jackdev23/morsedecode/EnhancedMorseDecoder/Code/SDRLxx_EnhancedMorseDecoder_DesignDescription.docx

# 33f

# Project Blue Horizon - Increment V

# Enhanced Morse Decoder

# Hardware Design Description

Revision | -
Date: | [ISSUE DATE]

Document Number: | [SDRLxx]
Status: | [DRAFT]
SDRL No: | xX
DOORS™ Module Reference: | N/A
Classification: | Unclassified

Dylan Thorner

Sean Winfree

This document is the property of ASCEND. If found, please return it to:

Lockheed Martin System Integration, ELDP Offices, 1801 State Route 17C
Owego, NY 13827-3998

Together with your name and address. Letter postage need not be prepaid.

Lockheed Martin Owego's Engineering Leadership Development Program (ELDP) is dedicated to the professional development of the company's future technical and business leaders. This comprehensive three-year program consists of rotational work assignments (http://www.owg.fs.lmco.com/projects/ldp/eldp/assignments.html), (http://www.owg.fs.lmco.com/projects/ldp/eldp/assignments.html) leadership training, and technical graduate studies leading to a Master of Engineering degree in Systems Engineering from Cornell University (http://www.owg.fs.lmco.com/projects/ldp/eldp/cornell.html). This proven combination of academics, in-house training and rotational assignments provides entry-level professionals with the broad-based exposure that will facilitate their ability to perform with distinction in the challenging leadership roles within Lockheed Martin Systems Integration.

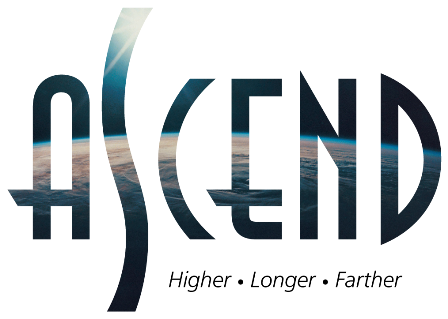
[picture p11: figure]

# Issue Record

The content of this document is wholly defined by the issue number and, where appropriate, the revision letter detailed below. The document will be reproduced in its entirety when any change has been incorporated and approved.

This document is under Configuration Control and any changes to the document will be subject to a change request via Configuration Management.

Revision | Incorporated by | Revision Date | Description of Change | CR(s) Applied
- | Sean Winfree | 12/31/2010 | DRAFT

# Authorization Notification

# Prepared by: Sean Winfree, Chief Engineer

# ASCEND;

Dylan Thorner, Engineer

Enhanced Solutions

# Approved by: <<APPROVER>>, <<ROLE>>

# ASCEND

# Contents

Figures

Tables

References

This table lists the documents applicable to the Hardware Design Docuement. It includes documents referred to in the text as well as related complementary documents that could be of interest to the reader.

ASCEND Docuementation

All ASCEND Documentation listed below is available in the Configuration Management (https://sharepoint.global.lmco.com/sites/Project-Blue-Horizon/PBH%202011/Forms/AllItems.aspx) folder on the PBH Sharepoint.

Doc # | Document Title
XX-XXX | Enhanced Morse Decoder White Paper
XX-XXX | Enhanced Morse Decoder ICD

Enhanced Solutions Docuementation

The following table lists all supporting documentation provided by Enhanced Solutions in reference to the design.

Doc # | Document Title
xx-xxx | Enhanced Morse Decoder Schematics
xx-xxx | Enhanced Morse Decoder Bill Of Materials
xx-xxx | Enhanced Morse Decoder Layout Artwork Images

Supplier Docuementation

The following table lists key supporting documentation provided by suppliers of components used in the design.

Doc # | Document Title
DS70xxxx | dsPIC33F Family Reference Manual Part 1 (24-Apr-2009)
DS51700A | MPLAB Starter Kit fordsPIC® Digital Signal Controllers User’s Guide

# 1. Scope

This Hardware Design Document (HDD) serves as both a receptacle of parts of the design and a pointer to additional descriptions of the design of the Hardware Configuration Items (HWCI) identified as the Enhanced Morse Decoder of the Project Blue Horizion (PBH) systems. This design was derived from requirements contained within the PBHV System Specification. All information required to understand the design of these HWCI is either provided here or assessed and referenced from this document.

The artifacts in the document were generated as part of the preliminary and detailed design phase as documented in the ASCEND PBH Intergrated Master Schedule.

## 1.1 System Overview

The PBH Increment V systems include the Air Vehicle and Ground Segment. Figure 1: PBH Inc. V System Overview details the interaction between the individual systems.

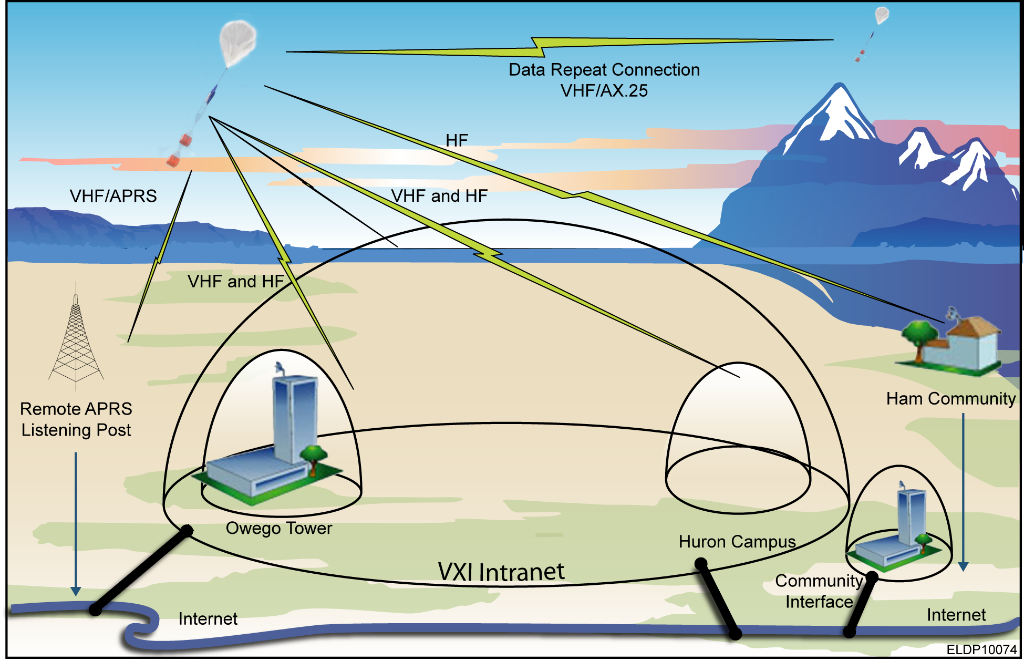
[picture p12: figure]

Figure 1: PBH Inc. V System Overview

## 1.1.1 Air Vehicle

The Air Vehicle contains the following items, detailed in Figure 1: Air Vehicle Block Diagram.

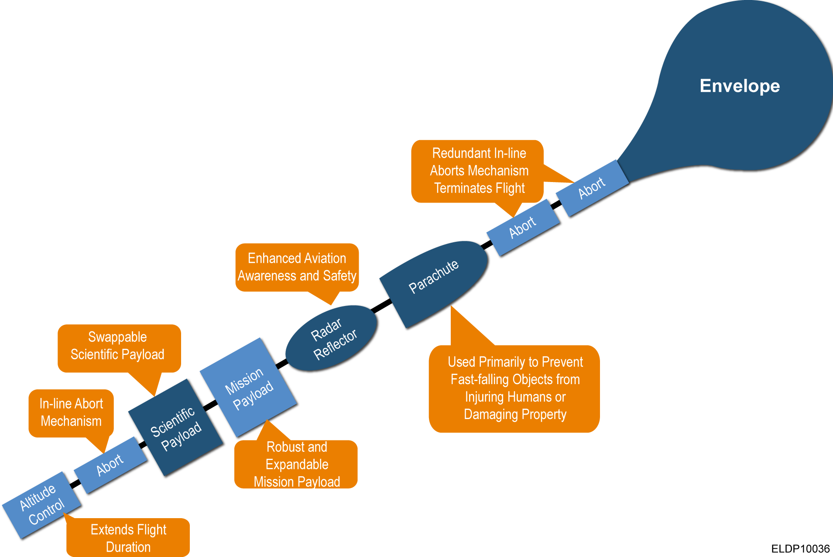
[picture p13: figure]

Figure 2: Air Vehicle Block Diagram

## 1.1.2 Mission Payload

The distance/duration Mission Payload configuration which includes the Enhanced Morse Decoder is shown in Figure 3: Distance/Duration Mission Payload Configuration.

Mission Payload TWI Service BusPower ControlGPS ProviderGPS ProviderHF Comm ProviderEHF Comm ProviderLassen iQ GPSLassen iQ GPSEnhancedMorse DecoderMorse DecoderTWITWITWITWITWIAbortBallast SystemDigital ControlPower Source (Batteries)Power Source (Batteries)Power Source (Batteries)RS-232/NMEABBRFDigital
ControlRFRFPower BusHF Antenna (40m)VHFAntennaRS-232/NMEADigitalControlMorse CodeStrobeRFGPSAntennaGPSAntennaGPSGPSBBRFRockmite
HF RadioRockmiteHF RadioMicroTrac300Morse CodeHF Antenna (30m)RS-232/NMEADigital
Control

Figure 3: Distance/Duration Mission Payload Configuration

## 1.2 Enhanced Morse Decoder Architecture Design

A very brief description of the Subsystem.

### 1.2.1 Enhanced Morse Decoder Overview

The Enhanced Morse Decoder (EMD) is used to decode Morse Code messages transmitted over the HF band.

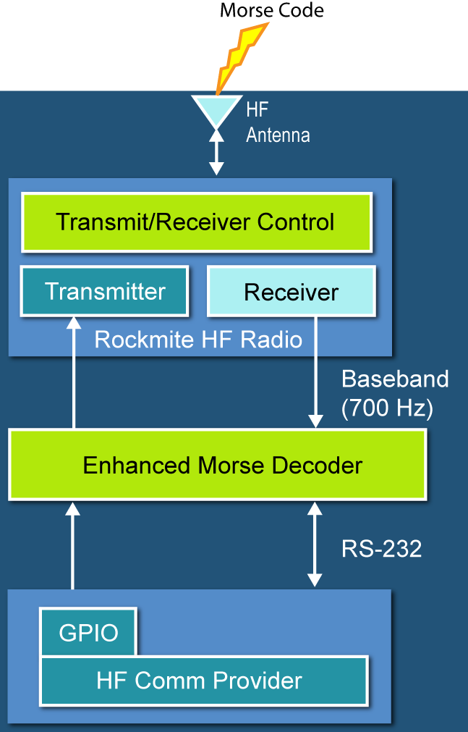
[picture p14: figure]

Figure 4: Enhanced Morse Decoder Block Diagram

### 1.2.2 Enhanced Morse Decoder Requirements Traceability

Traceability to requirements will be accomplished through indication via text within this document:

HRS Location

DOORS: Blue_Horizon/PBHV /<HRS FILE NAME>/

### 1.2.3 Enhanced Morse Decoder Trade Studies

(Optional) Describe any trade studies performed. Copy and past OR Reference from proposal if already completed.

### 1.2.4 Enhanced Morse Decoder Detailed Design

A description of the solution that systematically traces requirements through all levels of decomposition into the subsystem functions and features.

### 1.2.4.1 Enhanced Morse Decoder Block Definition Diagram

Block diagram of all interfaces only showing the EMD.

### 1.2.5 Enhanced Morse Decoder Mechanical Design

Design details on mechanical design. Weight break out here (just weigh the whole thing).

### 1.2.5.1 Enhanced Morse Decoder Printed Wiring Board Layout

Insert image(s) of PWB layout and reference a PDF of the Layout and final *.brd files (i.e. HW-101 EMD Board Layout.pdf).

### 1.2.6 Enhanced Morse Decoder Electrical Design

Discuss the electrical design. Talk about analog and DSC circuits.

### 1.2.6.1 Enhanced Morse Decoder Schematics (or Wiring Diagram)

Insert image(s) of schematics and reference a PDF of the schematics (i.e. HW-100 EMD Schematics.pdf) and final schematic files *.sch.

Notes:

- Any benefit to connect up ADC VREF nets? I doubt it..
- JTAG Header
- Recommend placing the same RS232 buffers we use on the flight computers to simplify debug. We can have 0 ohm resistors to bypass the buffer for actual operation.
- Appears that internal Fast RC Oscillator can generate 80Mhz (40MIPS). Does this get affected by temp? If so can we put down a external oscillator ~7.4HMz or something?
- What resistor/Cap changes are required to shift the frequency of the Bandpass filter from 700Hz to 300Hz?

### 1.2.7 Enhanced Morse Decoder Interface Description

Insert reference to the existing ICD.

### 1.2.8 Enhanced Morse DecoderBill of Materials

Reference the Bill of Materials document. Optional - put in entire list

### 1.2.9 Enhanced Morse DecoderSafety Functions / Properties

Discuss any safety considerations built into the design. Respond/justify and safety related design elements.

### 1.2.10 Enhanced Morse DecoderAssembly

Show the board file with clearly marked population notes (are there any Do Not Populate items (DNP))? See Example below. Red is DNP and Green is Populate with the value. Helpful in assembly. Document any special assembly consideration, notes or order of component placement as necessary.

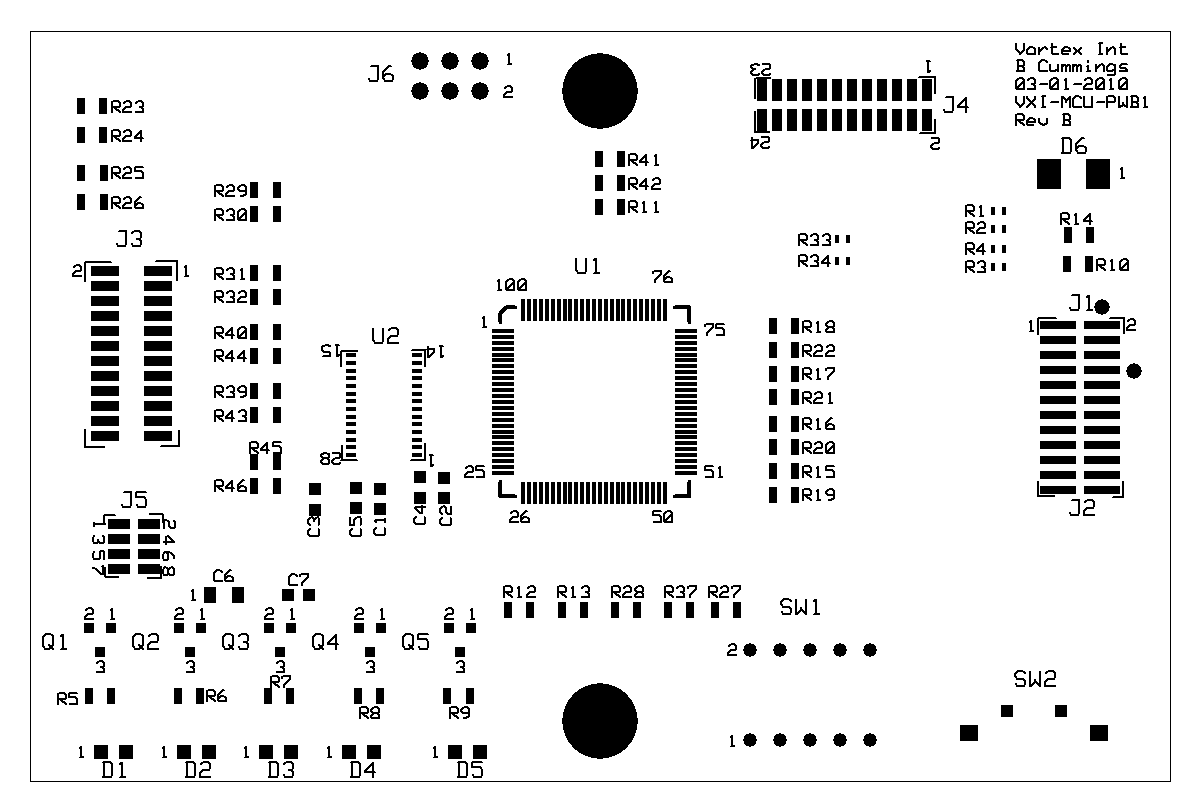
[picture p15: figure]

Vortex InternationalMicrocontroller Unit (MCU)Rev BPower controller (P)DNPDNPDNPDNP100 KDNPDNP 5 K5 K100K100K100K100K100K100K100 K100 K100 K1 K1 K1 K1 KDNPDNPDNPDNPDNPDNPDNPDNPDNPDNPDNP0 ohm100 KDNP DNPDNPDNP80.6 ohms80.6 ohms80.6 ohms80.6 ohms80.6 ohmsDNP

Appendix A.  Design Prototype
  A.1  Prototype Enhanced Morse Decoder

The MPLAB Starter Kit for dsPIC® Digital Signal Controllers (DSC-Starter Kit) is utilized to provide a prototype Enhanced Morse Decoder for software development. The following section details the DSC-Starter Kit configuration and analysis. For additional information reference the MPLAB Starter Kit fordsPIC® Digital Signal Controllers User’s Guide.

    A.1.1  Prototype Enhanced Morse Decoder Overview

The Enhanced Morse Decoder is used to decode Morse Code messages transmitted over the HF band.

Figure 5: DSK-Starter Kit Configuration

The SASK Record Play Demo with Intro Code Example demonstrates the low-cost speech capture and playback option. It uses the dsPIC DSC 12-bit ADC to capture speech samples. The data is stored in the serial Flash memory. The application then uses the Output Compare module in Pulse-Width Modulation (PWM) mode to generate a PWM signal representing the speech signal.

Note: Jumper J6 should in the OCPWM position to use this demo.

    A.1.2  Enhanced Morse Decoder Detailed Design

A description of the solution that systematically traces requirements through all levels of decomposition into the subsystem functions and features.

# A.1.2.1 Enhanced Morse Decoder Block Definition Diagram

Block diagram of all interfaces only showing the EMD.

    A.1.3  Enhanced Morse Decoder Mechanical Design

Design details on mechanical design. Weight break out here (just weigh the whole thing).

# A.1.3.1 Enhanced Morse Decoder Printed Wiring Board Layout

The following figure shows the schematic

    A.1.4  Enhanced Morse Decoder Electrical Design

Discuss the electrical design.

# A.1.4.1 Enhanced Morse Decoder Schematics

The Digital Signal Controller Starter Kit - Input/Output Diagram inputs and outputs are shown in the following figure. These lines are ulitilzed as

Figure 6: Digital Signal Controller Starter Kit - Input/Output Diagram

The incoming audio signal can come from a line input or a condenser microphone. The speech sampling input is jumper selected (J7). The selected signal is amplified by a non-inverting AC amplifier (Line/Microphone Amplifier) and routed to the ADC module on the dsPIC33F device through an anti-aliasing filter. This sixth-order Sallen-Key low-pass filter has a cut-off frequency of 3300 Hz. The output of the anti-aliasing filter is connected to input AN0 of the ADC module on the device. If the input to the amplifier is a condenser microphone, a bias voltage provides a working supply voltage for the microphone. The line input does not require this bias voltage.

    A.1.5  Enhanced Morse DecoderInterface Description

The following section defines all interfaces between the Prototype Enhanced Morse Decoder and all other subsystems.

Table 3: Enhanced Solutions ICD

Connector-Pin | Name | Subsystem Interface | Description | Direction.

    A.1.6  Enhanced Morse Decoder Bill of Materials

Put in entire list

Appendix B.  Acronyms

A list of relevant acronyms to the document

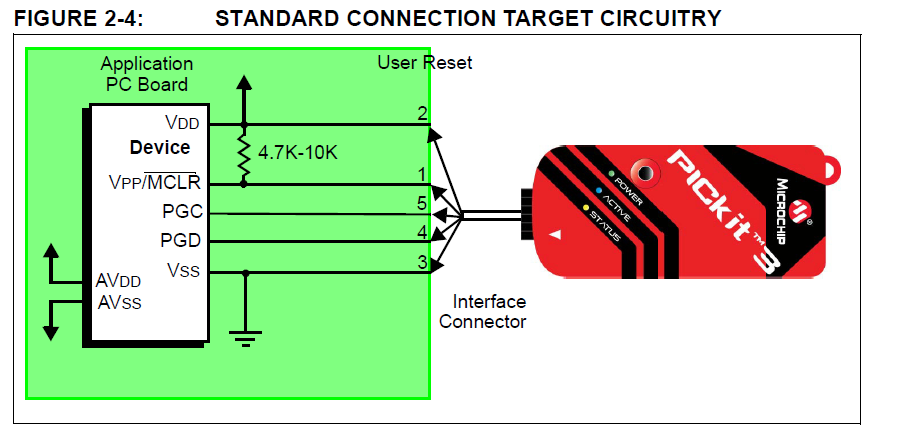
[picture p16: figure]

PicKit 3 Manual

Fin = 8MHz

M = 40 (38+2)

N1 = 2

N2 = 2

F

DSPIC33F Reference Manual – Oscillators

CL = 50pF C1 = C2 = 2xCL = 100pF

Page 6 of 3 Document Number: [DOC NUMBER] Unclassified

Unclassified Status: [DRAFT, DCA, FINAL] Issue: [ISSUE #] Author: Sean Winfree Issue Date: [ISSUE DATE] Title: [DOCUMENT TITLE] CDRL/SDRL No: [CDRL #, N/A]

Unclassified [CDRL #, N/A]: [DOCUMENT TITLE], [ISSUE #], [DRAFT, DCA, FINAL] [ISSUE DATE]
