jackdev23/morsedecode/PLL_Board/pll_resistors.JPG

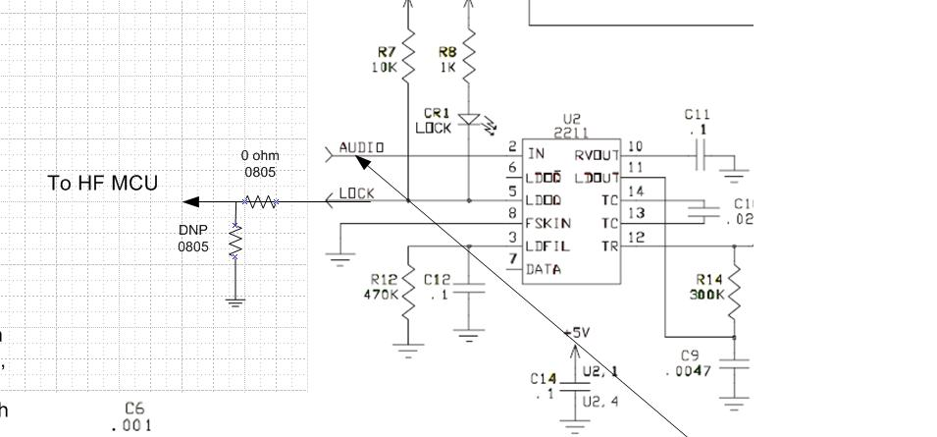
PLL_Board/pll_resistors.JPG
