jackdev23/morsedecode/EnhancedMorseDecoder/Decoder_PCB_BOM.xlsx

Reference Designator | Part Number | Description | Quantity per board | Price per Piece | Total Price | Actual # Purchased | Actual Price per Piece | Actual Total | Link to vendor website | Package Size | Notes
LED1,LED2 | LSR976-Z | LED - RED | 2 | $0.06 | $0.11 | 10 | $0.057 | $0.57 | http://www.newark.com/osram/lsr976-z/led-lamp/dp/97K3887?Ntt=LSR976-Z | n/a | Red LED
Q1 | ECS-80-18-4XDN | CRYSTAL 8.000 MHZ 18PF 49US | 1 | $0.80 | $0.80 | 5 | $0.800 | $4.00 | http://search.digikey.com/scripts/DkSearch/dksus.dll?Detail&name=X1115-ND | n/a
X3 |  | 6 pin header, Pitch 0.100 | 1 |  | $0.00 | 0 |  | $0.00 |  | n/a | Existing 2 Pin headers will be used
X5 |  | 16 pin header, Pitch 0.100 | 1 |  | $0.00 | 0 |  | $0.00 |  | n/a | Existing 2 Pin headers will be used
X1, X2, X6 | 70543-0001 | 2-Pin Vertical Connector, Pitch 0.100 | 3 | $1.05 | $3.15 | 0 |  | $0.00 | http://search.digikey.com/scripts/DkSearch/dksus.dll?Detail&name=WM4800-ND | n/a
C1,C2 | GRM1885C1H360JA01D | CAP CER 36PF 50V 5% C0G 0603 | 2 | $0.53 | $1.06 | 10 | $0.053 | $0.53 | http://search.digikey.com/scripts/DkSearch/dksus.dll?Detail&name=490-1416-1-ND | 0603 | For crystal, buy spares
R4,R5, R8 | ERJ-3GEYJ331V | RES 330 OHM 1/10W 5% 0603 SMD | 3 | $0.03 | $0.09 | 20 | $0.030 | $0.60 | http://search.digikey.com/scripts/DkSearch/dksus.dll?Detail&name=P330GCT-ND | 0603 | 1/10W 5%
R6 | ERJ-6ENF10R0V | RES 10.0 OHM 1/8W 1% 0805 SMD | 1 | $0.07 | $0.07 | 20 | $0.070 | $1.40 | http://search.digikey.com/scripts/DkSearch/dksus.dll?Detail&name=P10.0CCT-ND | 0805 | Either this or ferrite bead will be used for R6
R6 | BLM21PG221SN1D | FERRITE CHIP 220 OHM 2000MA 0805 | 1 | $0.06 | $0.06 | 10 | $0.056 | $0.56 | http://search.digikey.com/scripts/DkSearch/dksus.dll?Detail&name=490-1054-1-ND | 0805 | Either this or a 10 ohm resistor will be used for R6
C9, C13, C10 | TAJB226K020RNJ | CAP TANTALUM 22UF 20V 10% SMD | 3 | $0.63 | $1.89 |  |  | $0.00 | http://search.digikey.com/scripts/DkSearch/dksus.dll?Detail&name=478-1683-1-ND | 1210 | Tank cap
C3 | C3216X7R1C685K | CAP CER 6.8UF 16V X7R 10% 1206 | 1 | $0.60 | $0.60 | 20 | $0.605 | $12.10 | http://search.digikey.com/scripts/DkSearch/dksus.dll?Detail&name=445-4040-1-ND | 1206 | Must buy at least 10
C5,C6,C7,C8,C21 | 08055A102GAT2A | 1nF Ceramic Cap | 5 | $0.34 | $1.69 | 25 | $0.292 | $7.30 | http://www.newark.com/avx/08055a102gat2a/capacitor-ceramic-1000pf-50v-c0g/dp/96M1393 | 0805 | 50 V, 2% Tolerance
C14,C16,C18,C12,C15 | 12105C104KAZ2A | 0.1 µF Ceramic Cap | 7 | $0.27 | $1.89 | 50 | $0.256 | $12.80 | http://www.newark.com/avx/12105c104kaz2a/capacitor-ceramic-0-1uf-50v-x7r/dp/10R6038 | 1210 | 50 V, 10% Tolerance
R18,R19,R7 | CRCW060310K0FKEA | 10kΩ Thick Film Resistor | 4 | $0.04 | $0.17 | 25 | $0.060 | $1.50 | http://www.newark.com/vishay-dale/crcw060310k0fkea/resistor-thick-film-10kohm-100mw/dp/52K8062?Ntt=52K8062 | 0603 | 1% Tolerence, 100 mW
C20 | 57K1947 | 10µF Tantalum Cap | 2 | $0.48 | $0.95 | 10 | $0.446 | $4.46 | http://www.newark.com/kemet/t491d106k025at/capacitor-tant-10uf-25v-1ohm-7343/dp/57K1947 | 2917
R10 | 53K2000 | 150kΩ Think Film Resistor | 1 | $0.09 | $0.09 | 15 | $0.087 | $1.30 | http://www.newark.com/vishay-dale/crcw1206150kfkea/resistor-thick-film-150kohm-250mw/dp/53K2000 | 1206
R9 | 01N7009 | 180 kΩ Thick Film Resistor | 1 | $0.04 | $0.04 | 15 | $0.016 | $0.24 | http://www.newark.com/multicomp/mchp05w4f1803t5e/resistor-high-power-180kohm-250mw/dp/01N7009 | 0805 | Power Rating:250mW
R11 | P430KFCT-ND | 430k kΩ Resistor | 1 | $0.10 | $0.10 | 10 | $0.100 | $1.00 | http://search.digikey.com/scripts/DkSearch/dksus.dll?Detail&name=P430KFCT-ND | 1206
n/a | DSPIC33FJ128GP802-I/SO | IC DSPIC MCU/DSP 128K 28SOIC | 1 | $6.52 | $6.52 | 4 | $6.520 | $26.08 | http://search.digikey.com/scripts/DkSearch/dksus.dll?Detail&name=DSPIC33FJ128GP802-I/SO-ND | n/a | Microcontroller
U1,U2 | LT1677IS8#PBF | IC OPAMP R-R I/O SGL LN 8SOIC | 2 | $4.88 | $9.76 | 10 | $4.880 | $48.80 | http://search.digikey.com/scripts/DkSearch/dksus.dll?Detail&name=LT1677IS8%23PBF-ND | n/a | Op amp for filter
R15 | 300KFCT-ND | 300 kΩ Resistor | 2 | $0.10 | $0.20 | 10 | $0.100 | $1.00 | http://search.digikey.com/scripts/DkSearch/dksus.dll?Detail&name=P300KFCT-ND | 1206
R16 | P240KFCT-ND | 240 kΩ Resistor | 1 | $0.10 | $0.10 | 10 | $0.100 | $1.00 | http://search.digikey.com/scripts/DkSearch/dksus.dll?Detail&name=P240KFCT-ND | 1206
R17 | P750KFCT-ND | 750 kΩ Resistor | 1 | $0.10 | $0.10 | 10 | $0.100 | $1.00 | http://search.digikey.com/scripts/DkSearch/dksus.dll?Detail&name=P750KFCT-ND | 1206
R23,R2 | ERJ-6GEY0R00V | RES 0.0 OHM 1/8W 0805 SMD | 3 | $0.04 | $0.12 | 0 |  | $0.00 | http://search.digikey.com/scripts/DkSearch/dksus.dll?Detail&name=P0.0ACT-ND | 0805
TOTALS: |  |  | 50 |  | $29.57 |  |  | $126.24
