jackdev23/morsedecode/PLL_Board/PLL_PCB_BOM.xlsx

Reference Designator | Part Number | Description | Quantity per board | Price per Piece | Total Price | Link to vendor website | Notes
C5,C6,C7,C8,C21 | 96M1393 | 1000nF Ceramic Caps | 5 | $0.34 | $1.69 | http://www.newark.com/avx/08055a102gat2a/capacitor-ceramic-1000pf-50v-c0g/dp/96M1393
C11, C12, C14, C15, C16, C18 | 10R6038 | 0.1 µF Ceramic Cap | 6 | $0.27 | $1.62 | http://www.newark.com/avx/12105c104kaz2a/capacitor-ceramic-0-1uf-50v-x7r/dp/10R6038 | size: 1210
R20 | RNCP1206FTD100RCT-ND | 100Ω Thick Film Resistor | 1 | $0.09 | $0.09 | http://search.digikey.com/scripts/DkSearch/dksus.dll?Detail&name=RNCP1206FTD100RCT-ND | size:1206, 0.5 W
R7,R18,R19,R22 | 53K3601 | 10kΩ Thick Film Resistor | 4 | $0.33 | $1.32 | http://www.newark.com/vishay-dale/crcw201010k0fkef/resistor-thick-film-10kohm-500mw/dp/53K3601 | Temperature Coefficient is ± 100ppm, 1% tolerance
R21 |  | 0Ω Resistor | 1 |  | $0.00 |  | generic 0805 resistor
C19,C20 | 57K1947 | 10µF Tantalum Caps | 2 | $0.48 | $0.95 | http://www.newark.com/kemet/t491d106k025at/capacitor-tant-10uf-25v-1ohm-7343/dp/57K1947
R10 | 53K2000 | 150kΩ Think Film Resistor | 1 | $0.09 | $0.09 | http://www.newark.com/vishay-dale/crcw1206150kfkea/resistor-thick-film-150kohm-250mw/dp/53K2000 | size: 1206
R9 | 01N7009 | 180 kΩ Thick Film Resistor | 1 | $0.04 | $0.04 | http://www.newark.com/multicomp/mchp05w4f1803t5e/resistor-high-power-180kohm-250mw/dp/01N7009 | Temperature Coefficient:± 100ppm/°C Power Rating:250mW
R11 | P430KFCT-ND | 430k kΩ Resistor | 1 | $0.10 | $0.10 | http://search.digikey.com/scripts/DkSearch/dksus.dll?Detail&name=P430KFCT-ND | Size: 1206
U3A, U3B | 497-6990-1-ND | LM158 Dual Op Amp | 1 | $1.84 | $1.84 | http://search.digikey.com/scripts/DkSearch/dksus.dll?Detail&name=497-6990-1-ND | Replaced lm358 with lm158 for greater temp range, 2 amps/chip
R14, R15 | 300KFCT-ND | 300 kΩ Resistor | 2 | $0.10 | $0.20 | http://search.digikey.com/scripts/DkSearch/dksus.dll?Detail&name=P300KFCT-ND | size: 1206
R16 | P240KFCT-ND | 240 kΩ Resistor | 1 | $0.10 | $0.10 | http://search.digikey.com/scripts/DkSearch/dksus.dll?Detail&name=P240KFCT-ND | size: 1206
R17 | P750KFCT-ND | 750 kΩ Resistor | 1 | $0.10 | $0.10 | http://search.digikey.com/scripts/DkSearch/dksus.dll?Detail&name=P750KFCT-ND | size: 1206
R13, R23 | 47.0KFCT-ND | 47 kΩ Resistor | 2 | $0.10 | $0.20 | http://search.digikey.com/scripts/DkSearch/dksus.dll?Detail&name=P47.0KFCT-ND | size: 1206
R50 | 541-10.0MFDKR-ND | 10 MΩ Resistor | 1 | $8.02 | $8.02 | http://search.digikey.com/scripts/DkSearch/dksus.dll?Detail&name=541-10.0MFCT-ND | size:1206. NOTE: Must order a minimum of 10 (it was cheaper than buying a single resistor). The price for ten (8.02) is in included in this spread sheet but ten will be enough for 10 boards
R8 | P1.00KFCT-ND | 1 kΩ Resistor | 1 | $0.10 | $0.10 | http://search.digikey.com/scripts/DkSearch/dksus.dll?Detail&name=P1.00KFCT-ND | size: 1206
R12 | P470KFCT-ND | 470 kΩ Resistor | 1 | $0.10 | $0.10 | http://search.digikey.com/scripts/DkSearch/dksus.dll?Detail&name=P470KFCT-ND | size: 1206
CR1 | LSR976-Z | LED - RED | 1 | $0.06 | $0.06 | http://www.newark.com/osram/lsr976-z/led-lamp/dp/97K3887?Ntt=LSR976-Z | Should this be included?
C10 | 445-5114-1-ND | 0.022 µF Ceramic Cap | 1 | $8.00 | $8.00 | http://search.digikey.com/scripts/DkSearch/dksus.dll?Detail&name=445-5114-1-ND | Size: 0603 NOTE: Must order a minimum of 10 (it was cheaper than buying a single cap). The price for ten is in included in this spread sheet but ten will be enough for 10 boards
R1 | T93XA503KT20 | 50 kΩ 10 turn trimpot | 1 | $1.70 | $1.70 | T93XA-50K-ND (http://search.digikey.com/scripts/DkSearch/dksus.dll?Detail&name=T93XA-50K-ND) | Sean choose a part, but it could not be located in eagle
C9 | 490-1506-1-ND | 0.0047 µF Ceramic Cap | 1 | $7.24 | $7.24 | http://search.digikey.com/scripts/DkSearch/dksus.dll?Detail&name=490-1506-1-ND | Size: 0603 NOTE: Must order a minimum of 10 (it was cheaper than buying a single cap). The price for ten is in included in this spread sheet but ten will be enough for 10 boards
R24 | T93YA103KT20 | 10 kΩ 10 turn trimpot | 1 | $1.70 | $1.70 | T93YA-10K-ND (http://search.digikey.com/scripts/DkSearch/dksus.dll?Detail&name=T93YA-10K-ND) | Sean choose a part, but it could not be located in eagle
U2 | XR221A | XR-2211A FSK Tone Decoder | 1 | $2.65 | $2.65 | 1016-1309-5-ND (http://search.digikey.com/scripts/DkSearch/dksus.dll?Detail&name=1016-1309-5-ND) | Temp only down to 0C. This is a DIP part in schematic because SOIC-14 was not in eagle
R51, R52 | P2.00KAACT-ND | 2kΩ Resistor | 2 | $0.52 | $1.04 | http://search.digikey.com/scripts/DkSearch/dksus.dll?Detail&name=P2.00KAACT-ND | Size: 1210. This is possibly needed to fix a impedenace mismatch issue as mentioned by Andy
R53 |  | 0Ω Resistor | 2 |  | $0.00 |  | This part may be necessary if the 2k Resistor on the output is not needed
J1, J2, J3 | 70543-0001 | 2-Pin Vertical Connector, Pitch 0.100 | 3 | $0.99 | $2.97 | WM4800-ND (http://search.digikey.com/scripts/DkSearch/dksus.dll?Detail&name=WM4800-ND)
TOTALS: |  |  | 42 |  | $38.95
RED = part not chosen
 |  |  |  |  |  | WM4800-ND (http://search.digikey.com/scripts/DkSearch/dksus.dll?Detail&name=WM4800-ND)
