jackdev23/morsedecode/EnhancedMorseDecoder/Code/CE148_FIR_ADC_DMA/src/main.c

/**********************************************************************
* © 2007 Microchip Technology Inc.
*
* FileName:        main.c
* Dependencies:    Header (.h) files if applicable, see below
* Processor:       dsPIC33Fxxxx
* Compiler:        MPLAB® C30 v3.01 or higher
*
* SOFTWARE LICENSE AGREEMENT:
* Microchip Technology Incorporated ("Microchip") retains all ownership and 
* intellectual property rights in the code accompanying this message and in all 
* derivatives hereto.  You may use this code, and any derivatives created by 
* any person or entity by or on your behalf, exclusively with Microchip's
* proprietary products.  Your acceptance and/or use of this code constitutes 
* agreement to the terms and conditions of this notice.
*
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
* YOU ACKNOWLEDGE AND AGREE THAT, IN NO EVENT, SHALL MICROCHIP BE LIABLE, WHETHER 
* IN CONTRACT, WARRANTY, TORT (INCLUDING NEGLIGENCE OR BREACH OF STATUTORY DUTY), 
* STRICT LIABILITY, INDEMNITY, CONTRIBUTION, OR OTHERWISE, FOR ANY INDIRECT, SPECIAL, 
* PUNITIVE, EXEMPLARY, INCIDENTAL OR CONSEQUENTIAL LOSS, DAMAGE, FOR COST OR EXPENSE OF 
* ANY KIND WHATSOEVER RELATED TO THE CODE, HOWSOEVER CAUSED, EVEN IF MICROCHIP HAS BEEN 
* ADVISED OF THE POSSIBILITY OR THE DAMAGES ARE FORESEEABLE.  TO THE FULLEST EXTENT 
* ALLOWABLE BY LAW, MICROCHIP'S TOTAL LIABILITY ON ALL CLAIMS IN ANY WAY RELATED TO 
* THIS CODE, SHALL NOT EXCEED THE PRICE YOU PAID DIRECTLY TO MICROCHIP SPECIFICALLY TO 
* HAVE THIS CODE DEVELOPED.
*
* You agree that you are solely responsible for testing the code and 
* determining its suitability.  Microchip has no obligation to modify, test, 
* certify, or support the code.
*
* ADDITIONAL NOTES:
* Code Tested on:
* Explorer16 Demo board with dsPIC33FJ256GP710 controller 
**********************************************************************/


#include "p33fxxxx.h"
#include "dsp.h"
#include "..\h\adcDrv1.h"
#include "..\h\FIR.h"

//Macros for Configuration Fuse Registers:
//Invoke macros to set up  device configuration fuse registers.
//The fuses will select the oscillator source, power-up timers, watch-dog
//timers etc. The macros are defined within the device
//header files. The configuration fuse registers reside in Flash memory.



// Internal FRC Oscillator
_FOSCSEL(FNOSC_FRC);			// FRC Oscillator
_FOSC(FCKSM_CSECMD & OSCIOFNC_ON  & POSCMD_NONE); 
								// Clock Switching is wnabled and Fail Safe Clock Monitor is disabled
								// OSC2 Pin Function: OSC2 is Clock Output
								// Primary Oscillator Mode: Disabled


_FWDT(FWDTEN_OFF);              // Watchdog Timer Enabled/disabled by user software
								// (LPRC can be disabled by clearing SWDTEN bit in RCON register



int main (void)
{
	// Configure FRC to operate the device at 40MIPS
	// Fosc= Fin*M/(N1*N2), Fcy=Fosc/2
	// Fosc= 7.37M*43/(2*2)=79.2275Mhz for 40MIPS input clock
	PLLFBD=41;									// M=43
	CLKDIVbits.PLLPOST=0;						// N1=2
	CLKDIVbits.PLLPRE=0;						// N2=2
	OSCTUN=0;									// Tune FRC oscillator, if FRC is used

	// Disable Watch Dog Timer
	RCONbits.SWDTEN=0;

	// Clock switch to incorporate PLL
	__builtin_write_OSCCONH(0x01);				// Initiate Clock Switch to
												// FRC with PLL (NOSC=0b001)
	__builtin_write_OSCCONL(0x01);				// Start clock switching

	while (OSCCONbits.COSC != 0b001);			// Wait for Clock switch to occur

	while(OSCCONbits.LOCK!=1) {};				// Wait for PLL to lock

	// FIR Filter structure initialization
	FIRStruct FIRfilter;
	FIRStructInit(&FIRfilter,NY,coeffecients,0xFF00,z);
	FIRDelayInit(&FIRfilter);

	// Peripheral Initialisation
   	initAdc1();             					// Initialize the A/D converter to convert Channel 5
	initDma0();									// Initialise the DMA controller to buffer ADC data in conversion order
	initTmr3();									// Initialise the Timer to generate sampling event to ADC @ 250Khz rate

	TRISAbits.TRISA7 = 0;

	extern fractional BufferA[NUMSAMP];			// Ping pong buffer A
	extern fractional BufferB[NUMSAMP];			// Ping pong buffer B
	extern fractional outputSignal[NUMSAMP];	// Output buffer for the FIR filter output
	extern unsigned int DmaBuffer;				// DMA flag
	extern int flag;							// Flag

    while (1)               					//Loop Endlessly - Execution is interrupt driven
    { 
			 
		if(flag) 
		{            
			
			// Block FIR Call
			if(DmaBuffer == 0)
				FIR(NUMSAMP, &outputSignal[0], &BufferA[0], &FIRfilter);	// FIR filtering on BufferA 
			else
				FIR(NUMSAMP, &outputSignal[0], &BufferB[0], &FIRfilter);	// FIR filtering on BufferB 

			flag = 0;
		}
		
	}
    
	return 0;

}
