jackdev23/morsedecode/EnhancedMorseDecoder/Code/EnhancedMorseDecoder/filter103.h

/*
 * filter103.h
 *
 *  Created on: April 5th, 2011
 *      Author: SWINFREE
 *
 * this 103 tap filter made from matlab 
 * d=fdesign.lowpass('Fp,Fst,Ap,Ast',50,110,1,80,fsample);
 */

#ifndef FILTER103_H_
#define FILTER103_H_

#include "dsp.h"

#define NCOEFFS 103				// number of coeff
#define COEFF_PAGE_NUM 0xFF00   // coeff page number; data space = 0xFF00 

////////////////////////////////////////
// FIR Coeffecient Buffer
fractional filter86_coeffs[NCOEFFS] __attribute__ ((space(xmemory),far)) = {
0x0003,0x0005,0x0007,0x000a,0x000f,0x0014,0x001a,0x0021,0x0028,0x002f,0x0035,
0x003b,0x003f,0x0041,0x0040,0x003b,0x0031,0x0023,0x000f,0xfff6,0xffd7,0xffb4,
0xff8c,0xff62,0xff37,0xff0c,0xfee4,0xfec2,0xfea7,0xfe97,0xfe95,0xfea3,0xfec3,
0xfef7,0xff3f,0xff9d,0x0010,0x0098,0x0132,0x01db,0x0291,0x034f,0x0411,0x04d1,
0x058b,0x0639,0x06d6,0x075e,0x07cc,0x081d,0x084f,0x0860,0x084f,0x081d,0x07cc,
0x075e,0x06d6,0x0639,0x058b,0x04d1,0x0411,0x034f,0x0291,0x01db,0x0132,0x0098,
0x0010,0xff9d,0xff3f,0xfef7,0xfec3,0xfea3,0xfe95,0xfe97,0xfea7,0xfec2,0xfee4,
0xff0c,0xff37,0xff62,0xff8c,0xffb4,0xffd7,0xfff6,0x000f,0x0023,0x0031,0x003b,
0x0040,0x0041,0x003f,0x003b,0x0035,0x002f,0x0028,0x0021,0x001a,0x0014,0x000f,
0x000a,0x0007,0x0005,0x0003
};



// FIR Delay Buffer
fractional zR[NCOEFFS] __attribute__ ((space(ymemory),far)); 
fractional zI[NCOEFFS] __attribute__ ((space(ymemory),far)); 
////////////////////////////////////////

#endif /* FILTER103_H_ */
//EOF
