jackdev23/morsedecode/(commit log)

2010-10-04 Added MorseDecodeSimulation and PLL Board files
2010-10-11 Added Customer documents for Enhanced Solutions to review Added Eagle PLL board Project and schematic
    [PLL_Board.sch, PLL_PCB_BOM.xlsx]
2010-10-14 added HF Provider used with PLL Board
    [PLL_Board.sch]
2010-10-31 added comments/better graphics to simulation added details to white paper
    [PLL_Board.sch]
2010-11-02 PLL Board: Added datasheets, Completed PLL Board Schematics, Updated BOM.
    [PLL_Board.sch, PLL_PCB_BOM.xlsx]
2010-11-04 Started Board File
    [PLL_Board.brd]
2010-11-17 added noise mat files for dylan
    [PLL_PCB_BOM.xlsx]
2011-01-18 added adc
2011-01-19 updated Design Doc updated schematic added parts list
    [EMD_PCB_BOM.xlsx, EnhancedMorseDecoder_Board.brd, EnhancedMorseDecoder_Board.sch]
2011-01-19 chanced cap for osc
    [EnhancedMorseDecoder_Board.sch]
2011-01-20 Completed schematic DJT
    [EnhancedMorseDecoder_Board.sch]
2011-01-20 Initial board file
    [EnhancedMorseDecoder_Board.brd, EnhancedMorseDecoder_Board.sch]
2011-01-20 input bom -sww
    [EMD_PCB_BOM.xlsx]
2011-01-20 First board layout
    [EnhancedMorseDecoder_Board.brd, EnhancedMorseDecoder_Board.sch]
2011-01-26 added crystal
    [EMD_PCB_BOM.xlsx]
2011-01-29 Updated BOM for decoder PCB
    [Decoder_PCB_BOM.xlsx]
2011-01-29 Updated with most parts but still missing headers
    [Decoder_PCB_BOM.xlsx]
2011-01-30 Initial routing halfway done
    [EnhancedMorseDecoder_Board.brd, EnhancedMorseDecoder_Board.sch]
2011-01-31 Initial layout, 16 pin header not routed
    [EnhancedMorseDecoder_Board.brd, EnhancedMorseDecoder_Board.sch]
2011-02-01 modified schematics and pwb to route dspic to header
    [EnhancedMorseDecoder_Board.brd, EnhancedMorseDecoder_Board.sch]
2011-02-03 Text file to act as a "mutex" for modifying the board files
2011-02-06 Layout and schematic pre-review. Silkscreen not done
    [EnhancedMorseDecoder_Board.brd, EnhancedMorseDecoder_Board.sch]
2011-02-10 PICKIT3 header labeled
    [EnhancedMorseDecoder_Board.brd]
2011-02-19 added print to file
2011-02-19 added filter
2011-02-19 Added files for LEDS
2011-02-19 cleaned up code, initialize filter delay
2011-03-14 Oscillator set up for 40 MIPS operation? (not yet tested...)
    [main.c, oscillator.c, oscillator.h]
2011-03-28 Added this project because it goggles a pin at 1/4 the system clock frequency and it was used to test that the oscillator configuration was correct.
    [main.c, traps.c]
2011-03-29 ADC code in progress of being modified
2011-03-30 added init timer. WHY are your re-writing these functions!?
2011-03-31 added example of window avg filter and comments/concerns with it
2011-04-01 figured out how to simulate and started testing/fixing dsp code
    [decoder_dsp.c, decoder_dsp.h, main.c]
2011-04-01 added filter test function
2011-04-01 Filter test passes
2011-04-01 changed filter coeffs
2011-04-01 fixed filter coeff generation and tested filter
2011-04-01 Added ADC test code
2011-04-03 added testing for filter
2011-04-05 added filter103 which is at 50Hz pass band 110Hz stopband
2011-04-06 changed Signal of interest to 600Hz, increased window filter, decreased threshold
2011-04-10 DJT - Added code to check for a number of samples before considering the signal detected and added code for dynamic thresholding based on a digital input.
2011-04-28 minor changes. this is what was flown
